deba168/MPPT_Master/LCD__code/button_schem.png

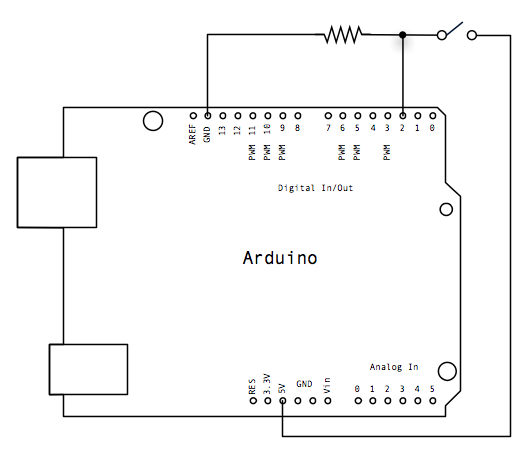
LCD__code/button_schem.png
