deba168/MPPT_Master/LCD__code/PushButtonSchematic.png

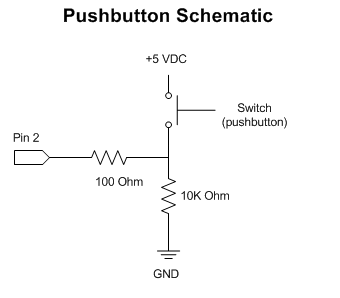
LCD__code/PushButtonSchematic.png
