deba168/MPPT_Master/mppt controller_schema.pdf

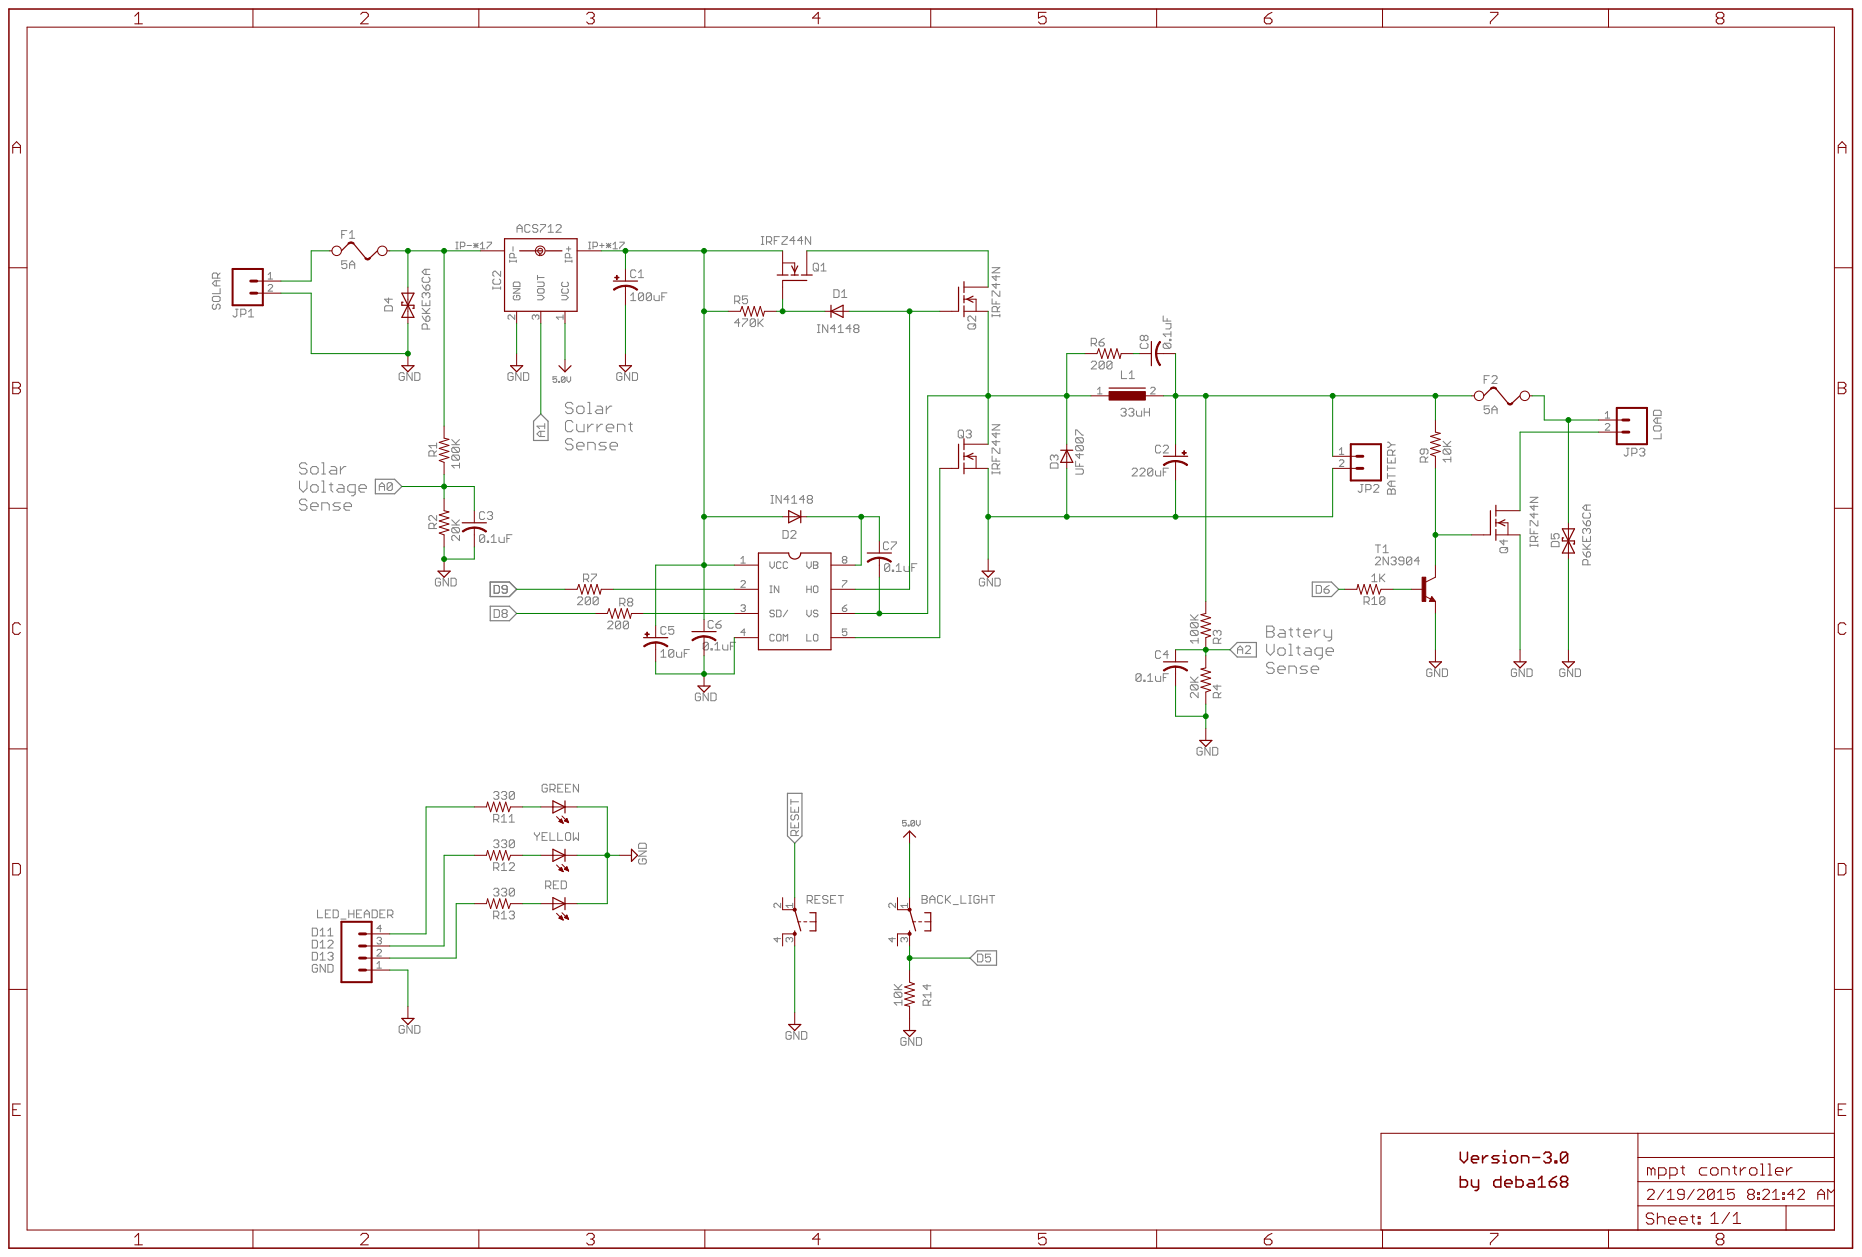
[picture p3: page 1]
