deba168/MPPT_Master/(threads)

Thread 1 (2015-05-24):

measure output current

bobricius, 2015-05-24:
It can be nice measure curent from battery to load. I understand that this feature is not required for Mppt. Just for loging, battry life, etc

rkuris, 2015-06-29:
This should be a pretty easy modification, just add another ACS712 before the load circuit and route that to an unused analog pin.

Thread 3 (2015-06-29):

Snubber design to reduce EMI and increase efficiency

rkuris, 2015-06-29:
The snubber used is a RC (R6 200ohm and C8 0.1uF) across the inductor. I am wondering if it's more efficient and less noisy to use a RC + C snubber. My solar controller will be near some radio equipment and I'd like to eliminate any ringing from the inductor.

There's a good article about this here: http://www.hagtech.com/pdf/snubber.pdf and I plan on doing some testing to make a better snubber.

Thread 5 (2015-07-02):

During startup, Q3 shorts the battery

rkuris, 2015-07-02:
This happens first due to the high impedance of the data lines during startup, but the code should turn the mosfet's off as soon as possible.

rkuris, 2015-07-02:
@deba168 is this problem solved by my last fix? Can you close this issue if it is?

deba168, 2015-07-02:
Hi I have till now not tested it.
Still doubt how the charger on.where it is written in loop ?
Have you tested it ?
Thanks
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

Thread 10 (2015-07-05):

Make the battery icon show the state of charge

rkuris, 2015-07-05:
The battery icon always shows about half full. Change the code to show the state of charge.

rkuris, 2015-07-06:
Fixed

Closed 2015-07-06.

Thread 15 (2019-08-01):

40V 300W Solar Cell Voltage Limit

MarkOude, 2019-08-01:
Hello,

I have a 300W Solar Cell laying around and I want to use it wit yout MPPT-Design.
The problem: it has about 40V maximum.
Where is the 25V limit, I mean the mosfets can handle 55V...

Is the Problem D2 ( the MOSFET-Diver ), because it is directly conneted to the solarcell Voltage?
A Solve would be to just use a LM2596 Buck converter and drive D2 with that voltage..

Or is it somewhere else?

Sorry for my (hopefully not so) bad English.

Gerne auch in Deutsch ;-)

nandar3193, 2019-08-01:
Hi,

could you pls send me your drawing diagram, or pls get me on skype :
nandar.mtn

regards
Nandar

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

MarkOude, 2019-08-01:
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

Hi,

I thought of something like this...

I don't know if i could run this thing with that schematic on 40V or if something else would be damaged at this voltage level or if it would work flawlessly fine...

best regards
Mark

deba168, 2019-08-01:
Hi,
This project is not fully functional. You can go through the comments
section, for modification. You can ask your question there.

Regards
Debasish

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
