deba168/MPPT_Master/(commit log)

2015-03-27 ARDUINO MPPT SOLAR CHARGE CONTROLLER (Version-3.0)
    This is an Arduino based Solar MPPT charge controller.It is designed to
    charge 12V lead acid battery by a solar panel of 50W.
2015-06-24 Scan the state more often
    The code previously scanned fairly rarely due to the thingspeak code long delay.
    Now it scans every second or so, making adjustments to the PWM more frequent.
    This code also adds a spinner so you can verify that it's adjusting things.
2015-06-24 General code cleanup and improvements
    Started moving some of the constants on the display to the initialization section.
    Computed things instead of having some big switch-like statements.Z
2015-07-02 Also start with the charger state off
2015-07-03 Turn on mosfet when switching from OFF to ON.
2015-07-05 Battery icon changes
    Added code to display 6 different battery icons depending on state of charge.
    Corrected a problem with an extra % sign on the PWM percentage
    Changed from a spinner to a flashing asterisk (less distracting)
    Resolves issue #10
    [MPPT_Code_ESP8266.ino]
2015-07-05 Load algorithm improvements
    The code now supports two algorithms, you can decide at compile time.
    The first algorithm (the default) will turn on the load when the
    battery is not fully discharged and there is no solar power. You'd use
    that for lighting. The second algorithm turns on the load when the
    battery is fully charged and there is solar power. You'd use that as
    a dump circuit (if you have something to do with excess power).
